hiteshbhoyar03/fpv-flight-controller-v4/gallery/fc 1 mcu.png

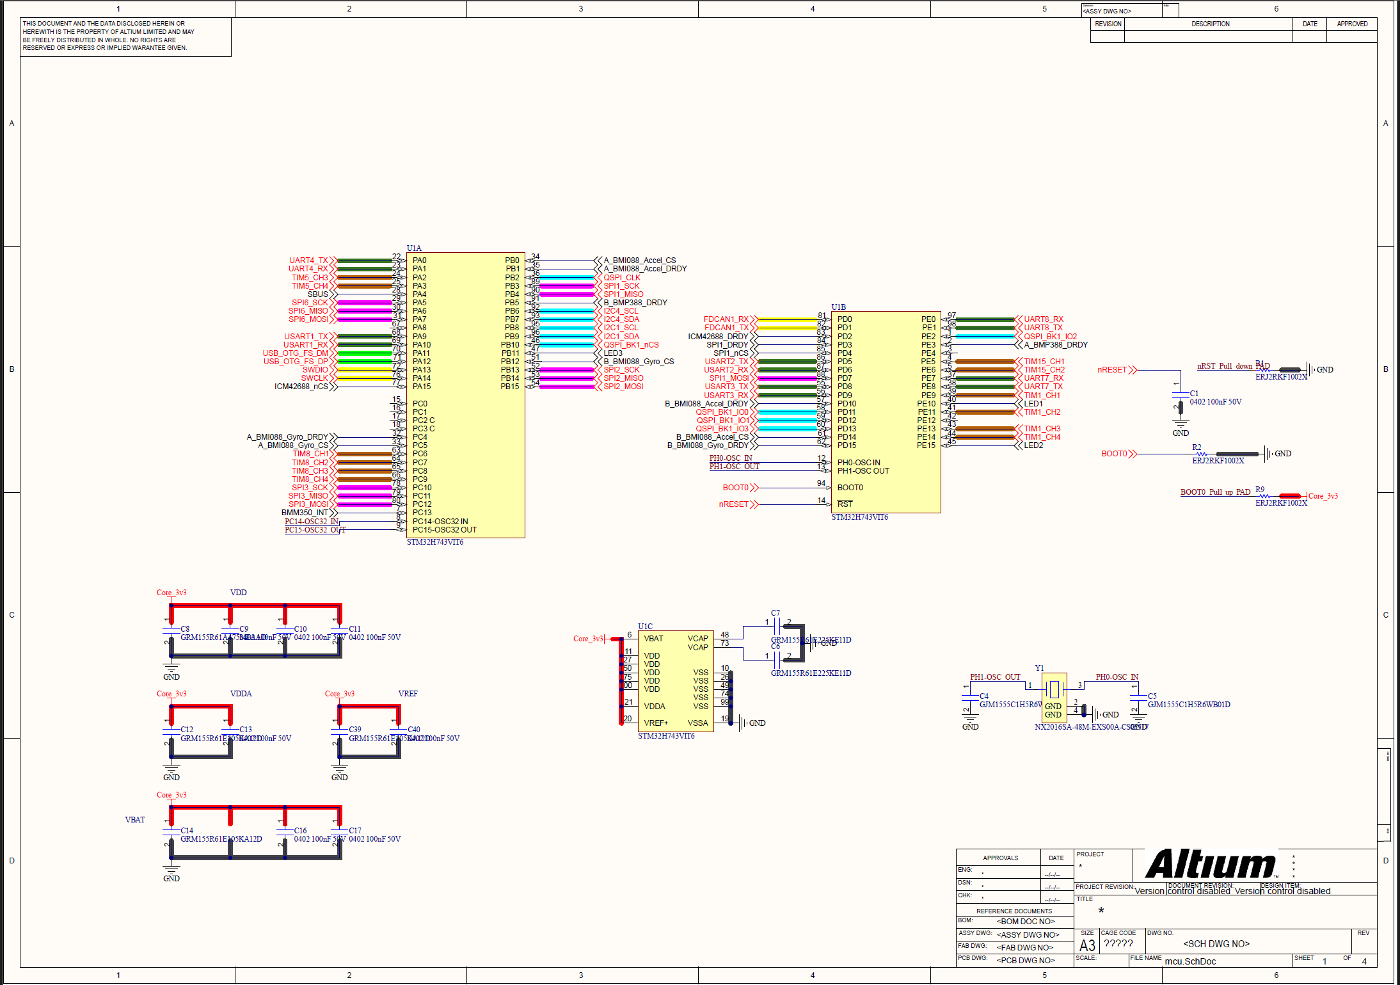
gallery/fc 1 mcu.png
