hiteshbhoyar03/fpv-flight-controller-v4/gallery/fc 2 sensor.png

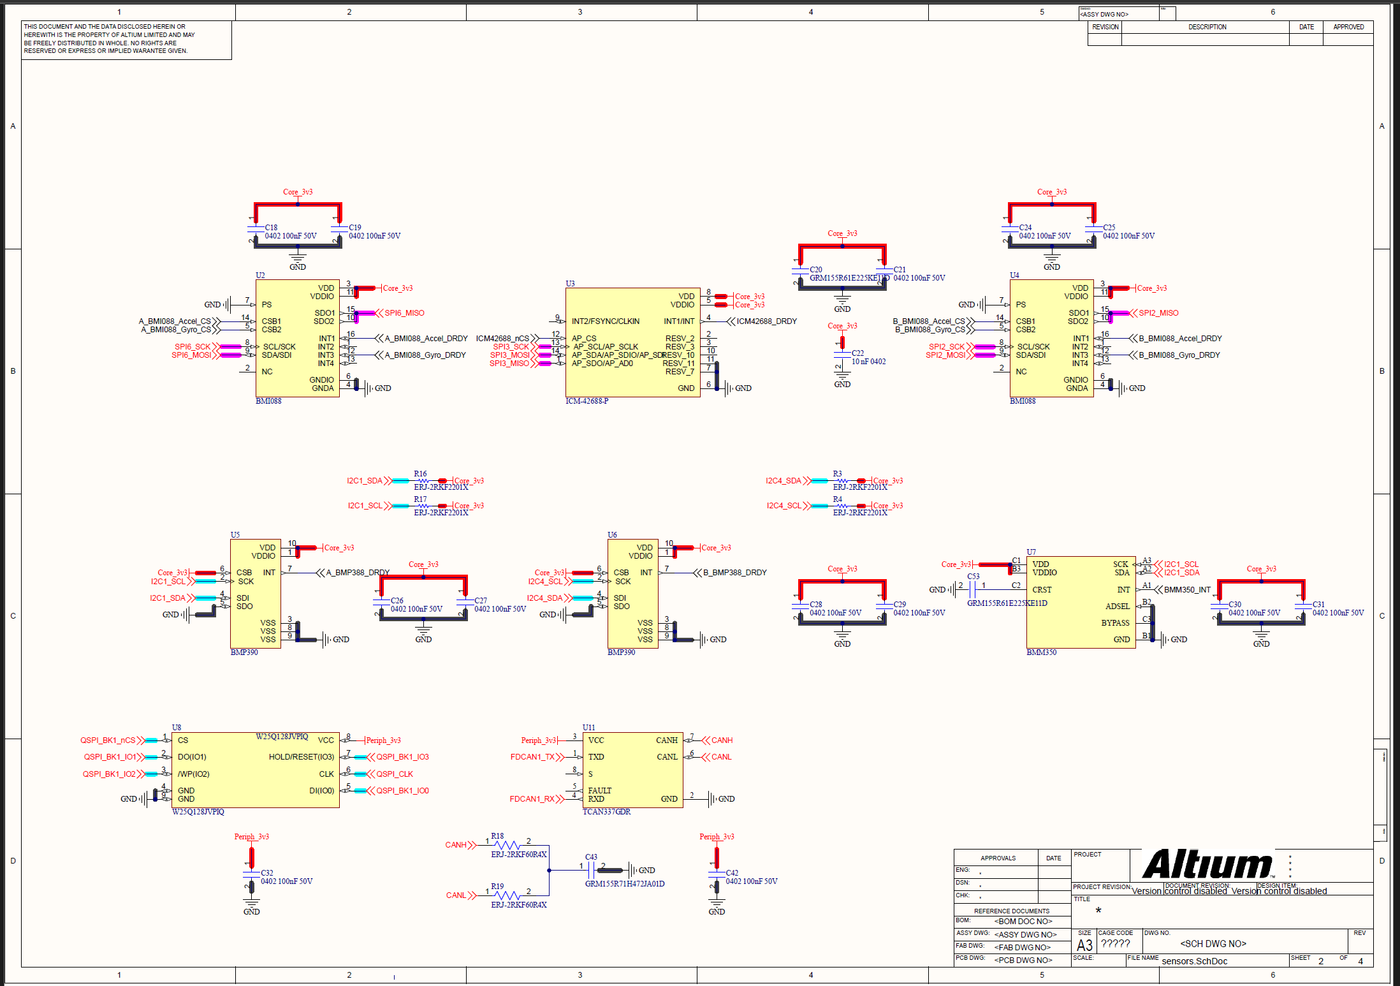
gallery/fc 2 sensor.png
