hiteshbhoyar03/fpv-flight-controller-v4/gallery/fc 3 power.png

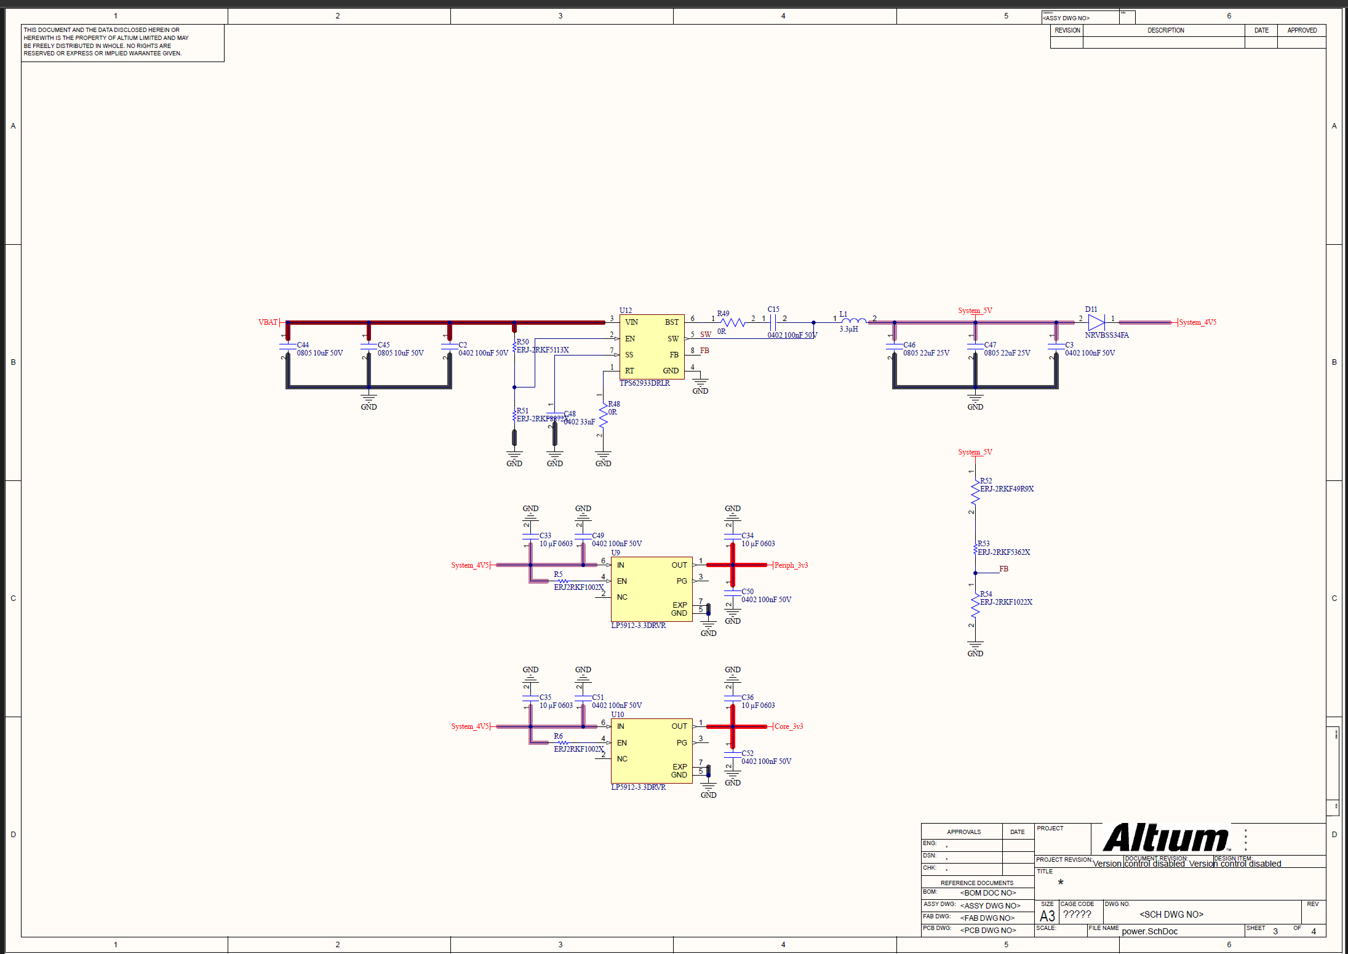
gallery/fc 3 power.png
