hiteshbhoyar03/fpv-flight-controller-v4/gallery/fc 4 ports.png

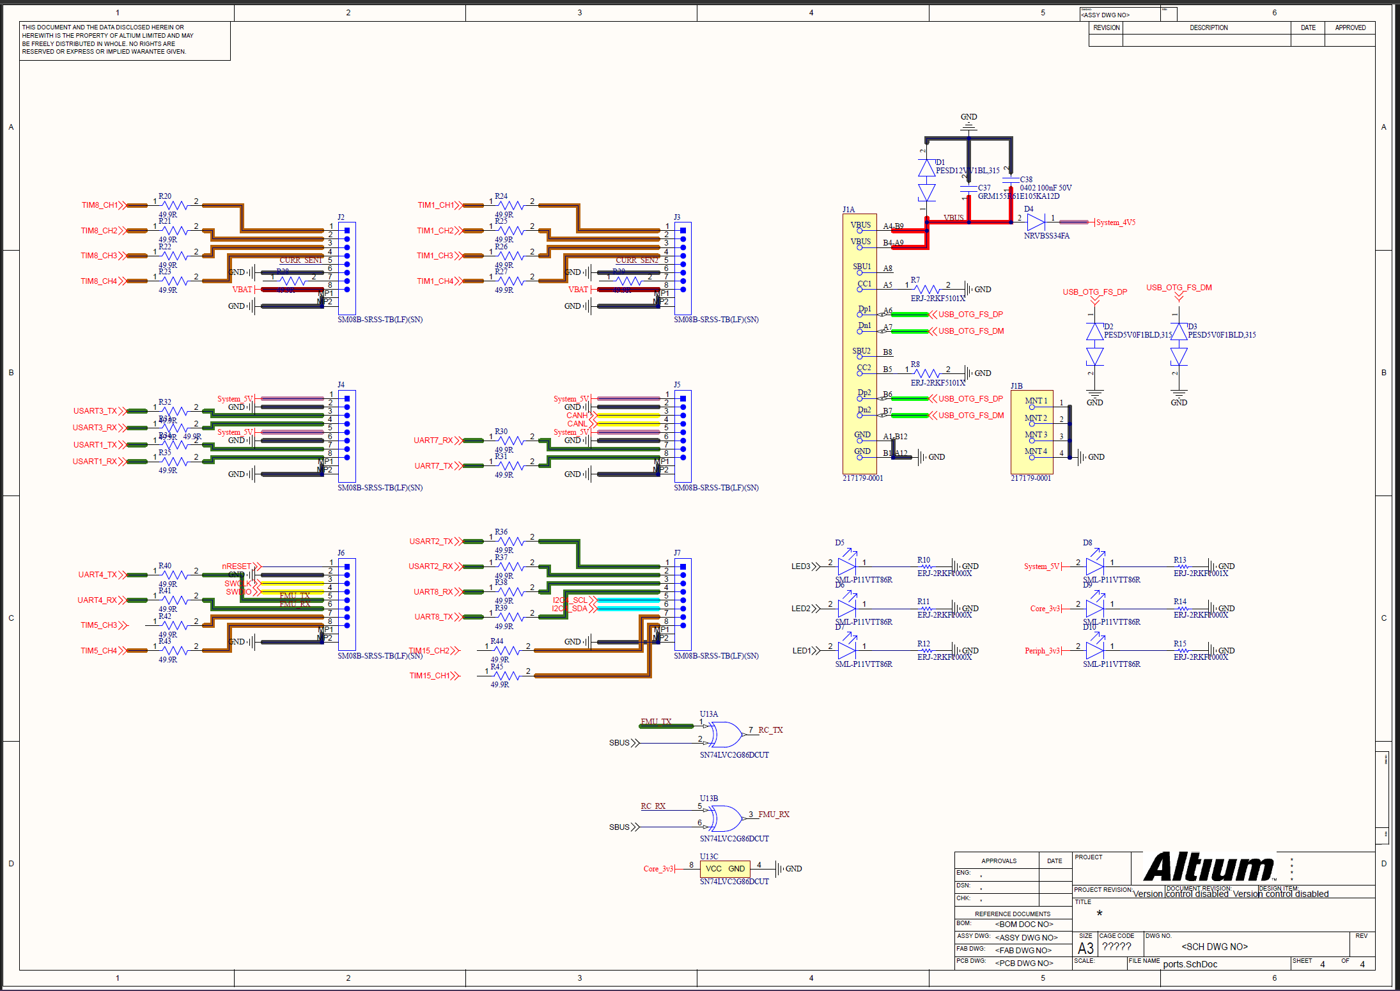
gallery/fc 4 ports.png
