hiteshbhoyar03/fpv-flight-controller-v4/gallery/fc layer1.png

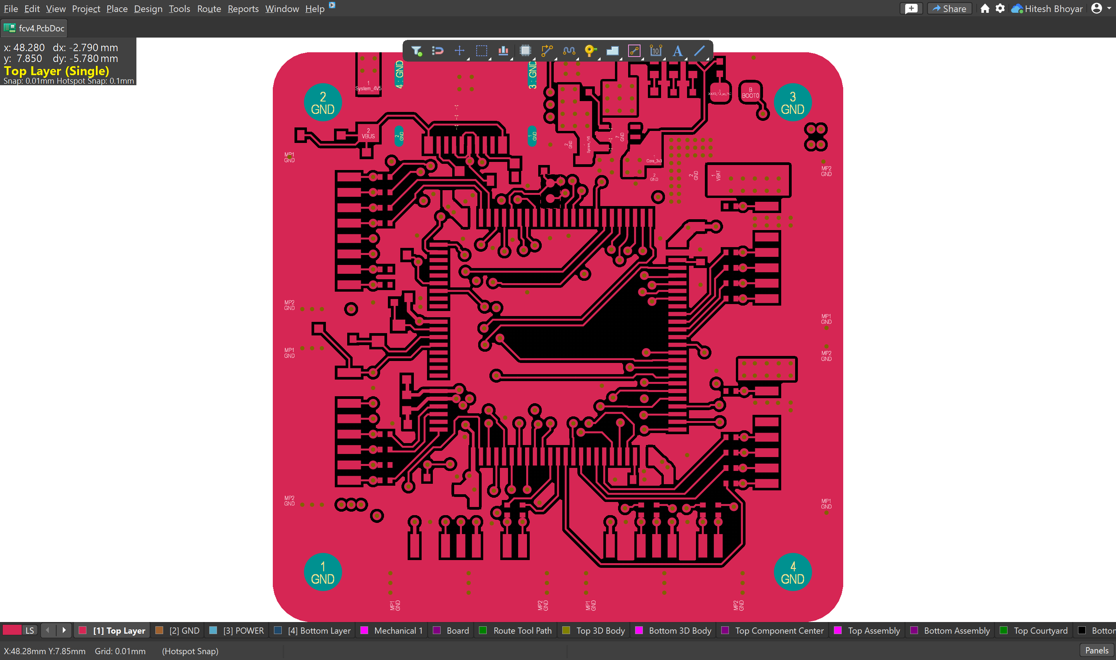
gallery/fc layer1.png
