hiteshbhoyar03/fpv-flight-controller-v4/gallery/fc layer2.png

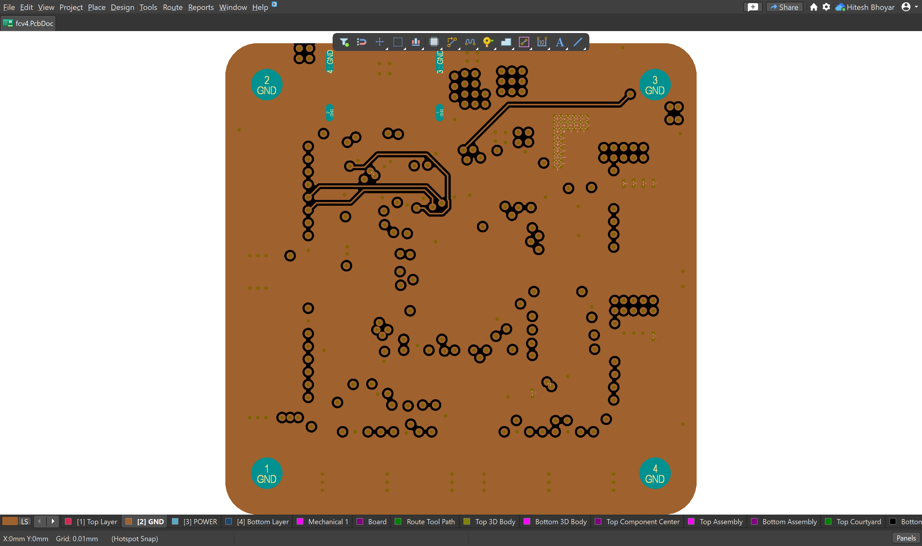
gallery/fc layer2.png
