hiteshbhoyar03/fpv-flight-controller-v4/gallery/fc layer3.png

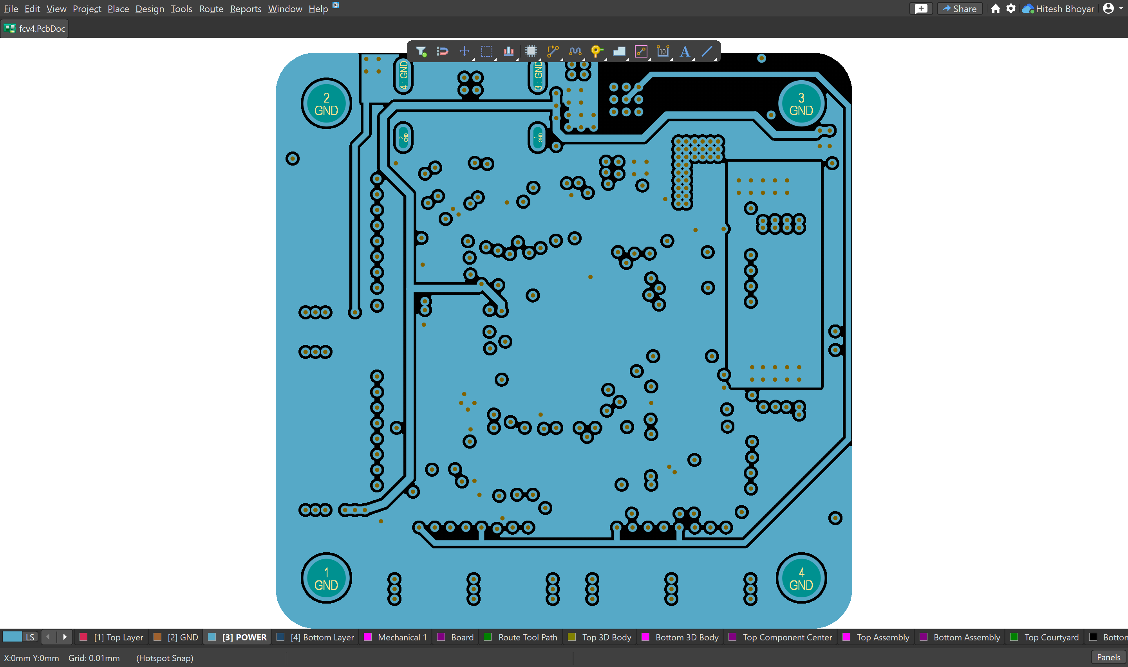
gallery/fc layer3.png
