hiteshbhoyar03/fpv-flight-controller-v4/gallery/fc layer4.png

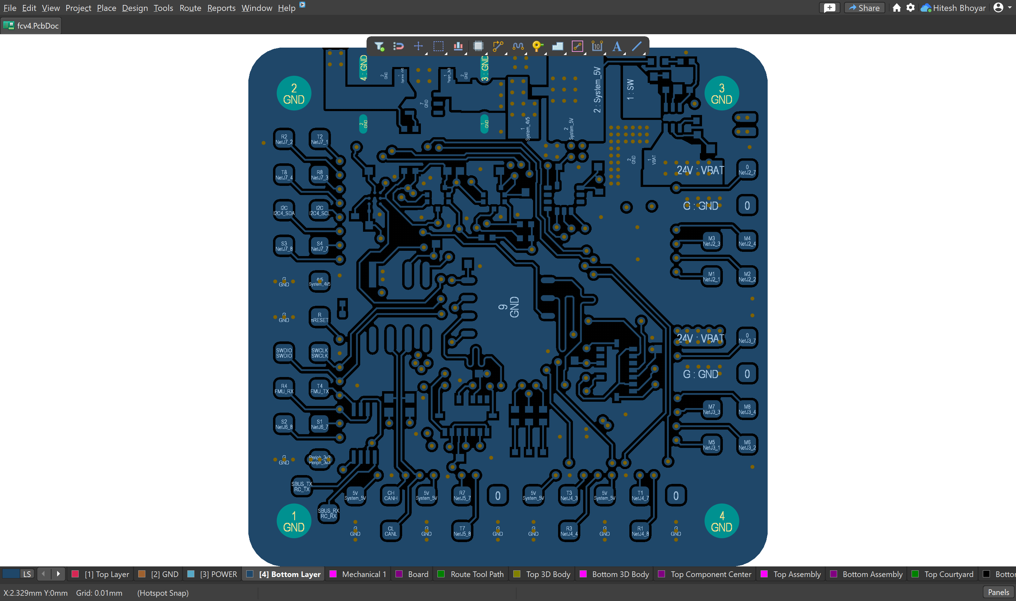
gallery/fc layer4.png
