hiteshbhoyar03/fpv-flight-controller-v4/documentation/fpv fc Assembly Drawings.pdf

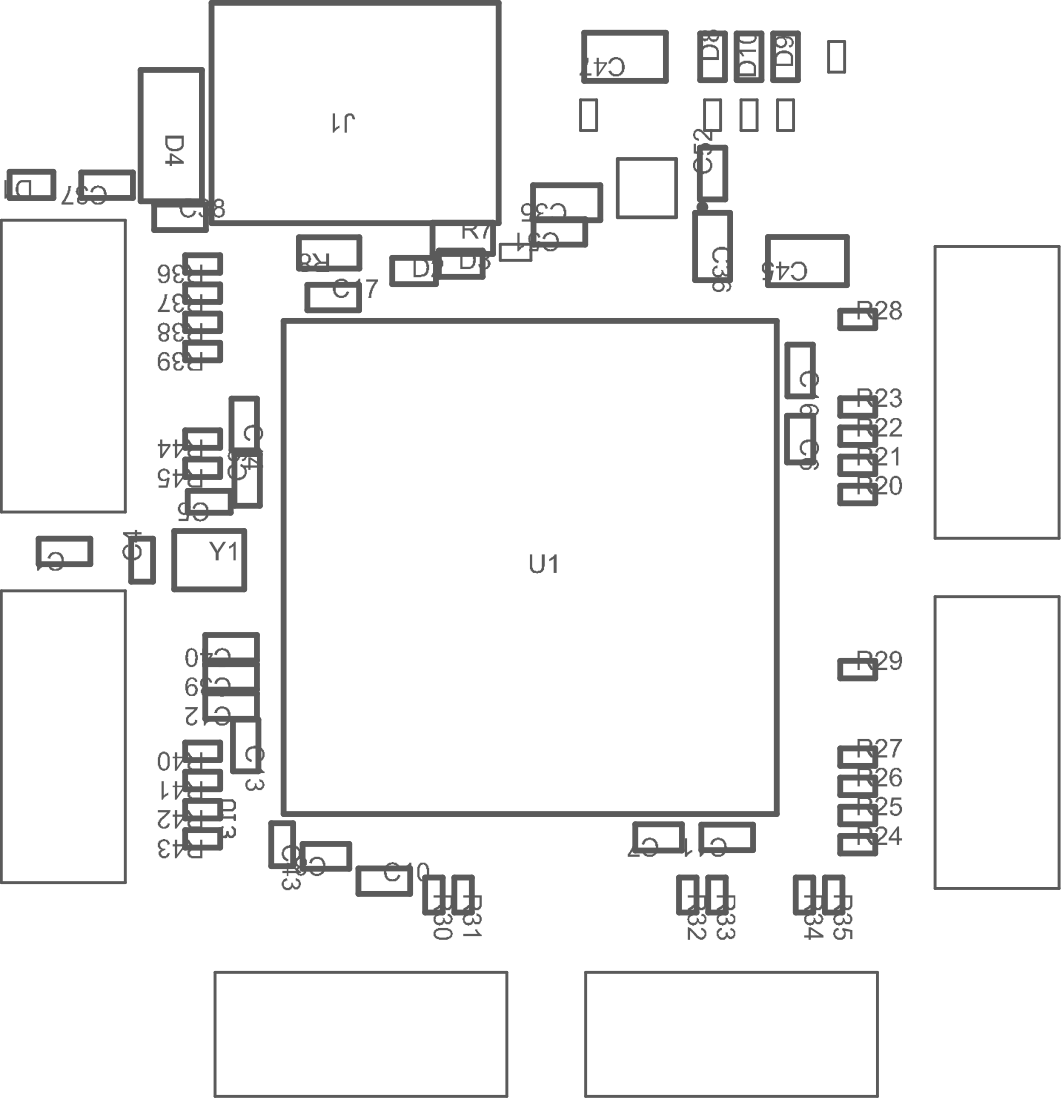
[picture p13: page 1]

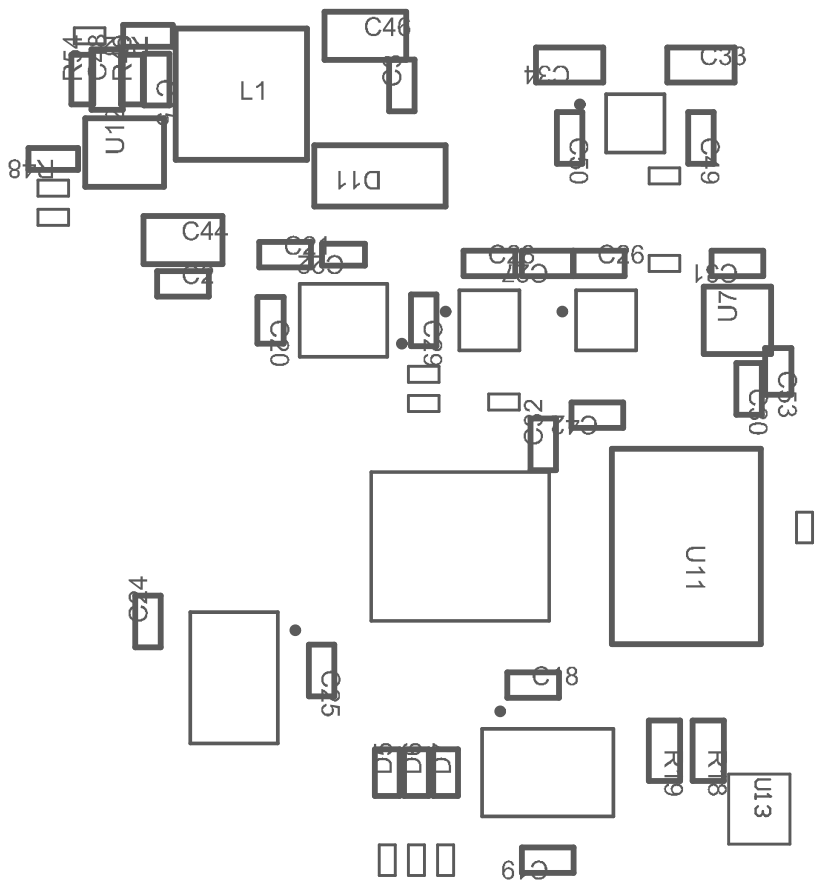
[picture p14: page 2]
