hiteshbhoyar03/fpv-flight-controller-v4/documentation/fpv fc Schematic PDF.pdf

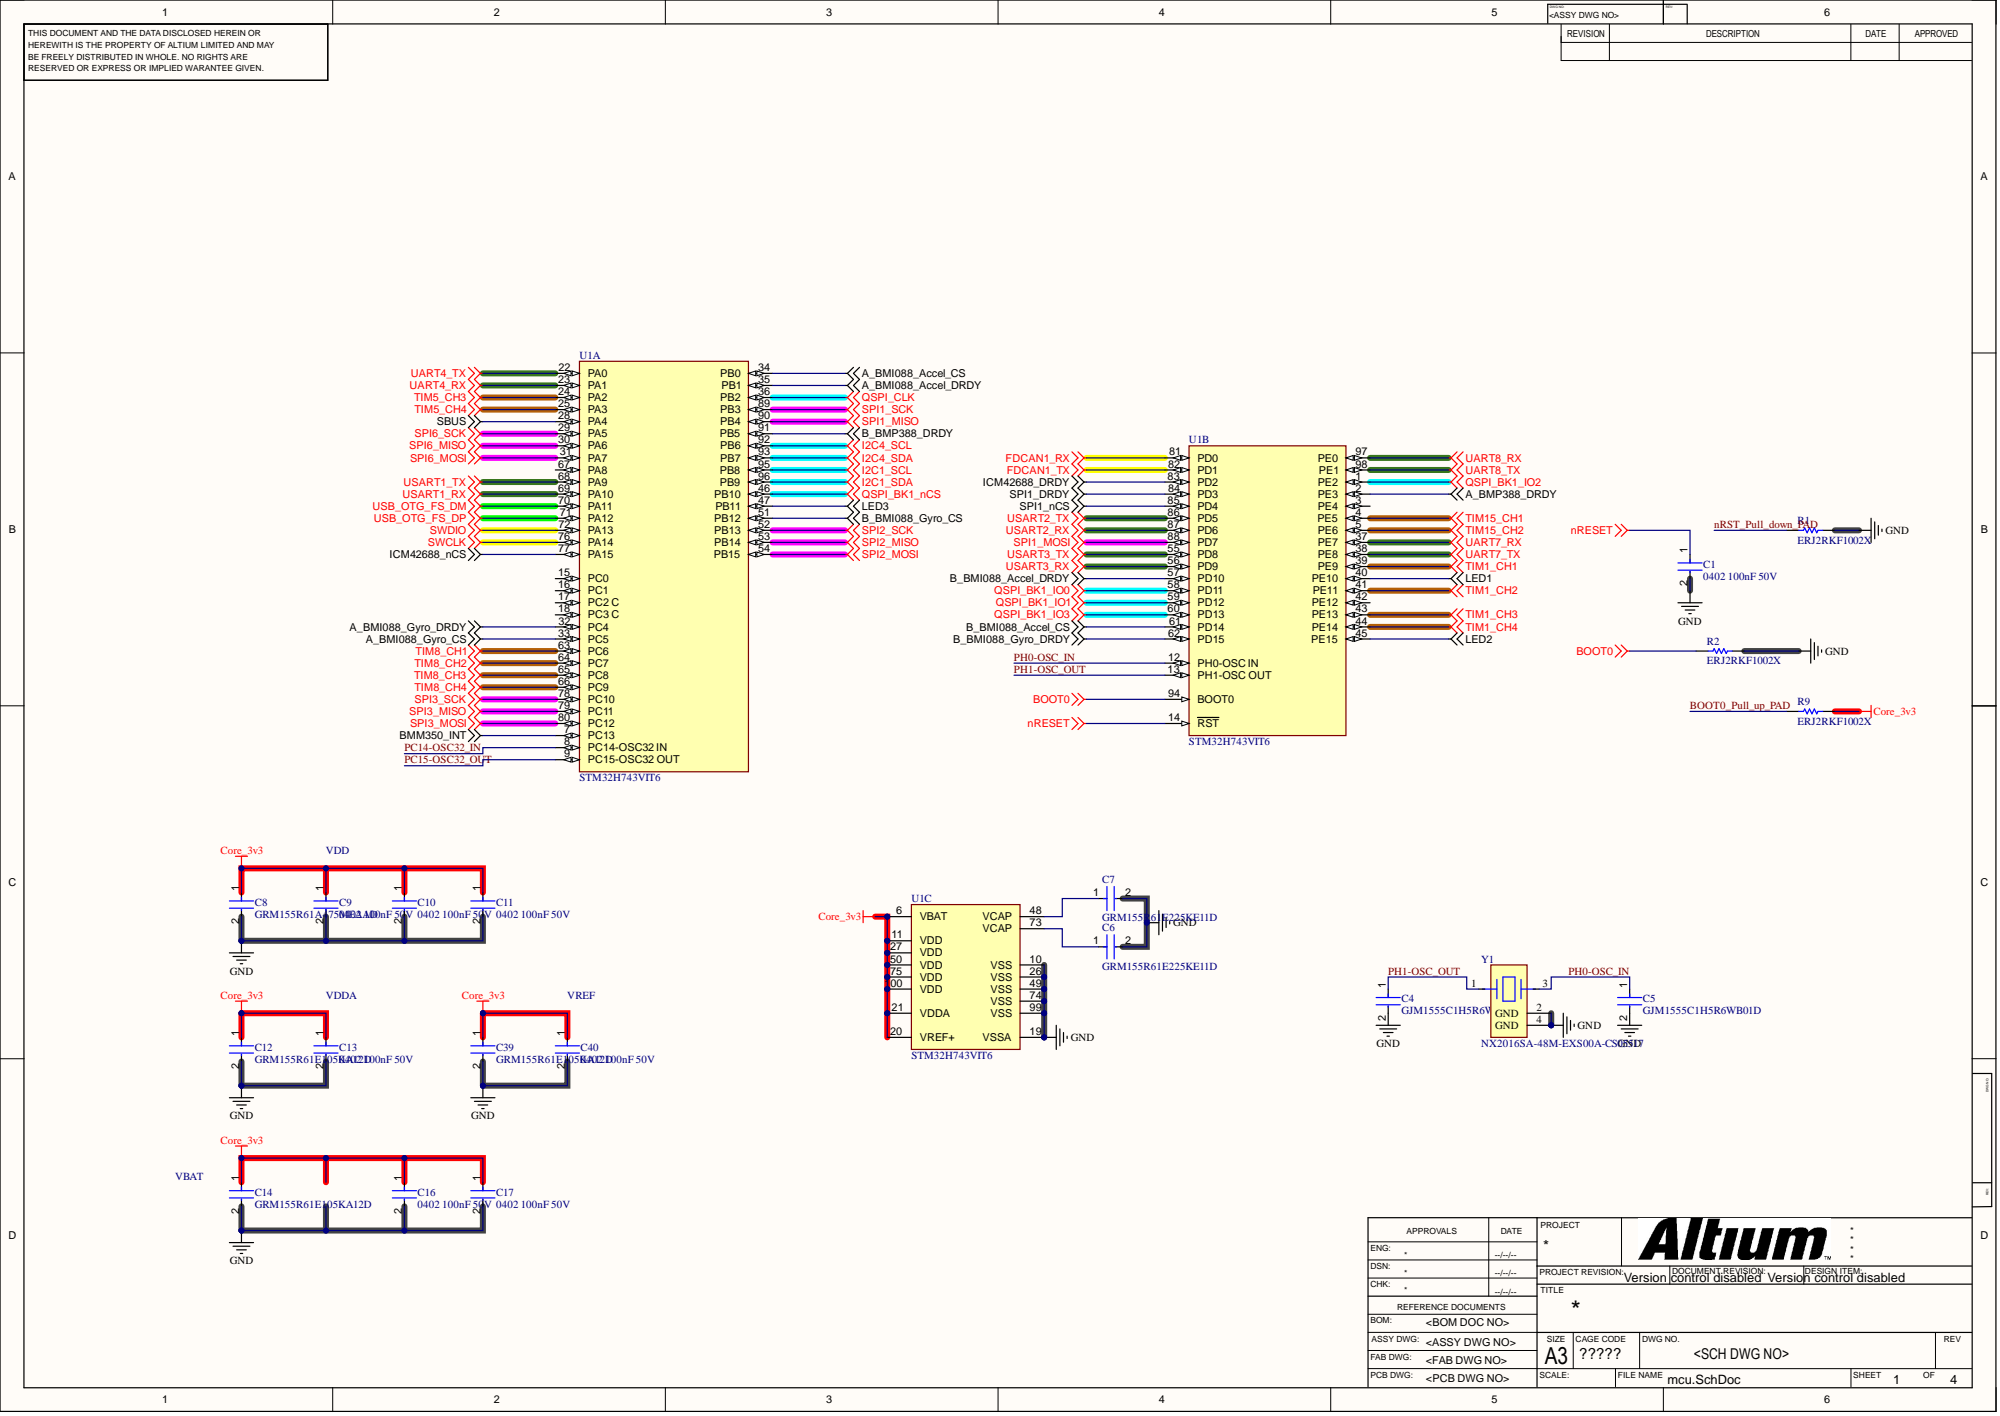
[picture p15: page 1]

DWG NO: <ASSY DWG NO> | REV:

THIS DOCUMENT AND THE DATA DISCLOSED HEREIN OR HEREWITH IS THE PROPERTY OF ALTIUM LIMITED AND MAY BE FREELY DISTRIBUTED IN WHOLE. NO RIGHTS ARE RESERVED OR EXPRESS OR IMPLIED WARANTEE GIVEN. | U1A | REVISION | DESCRIPTION | DATE | APPROVED

DATE | PROJECT * | * * APPROVALS * *

ENG: * | --/--/--

DSN: * | --/--/--

CHK: * | --/--/--

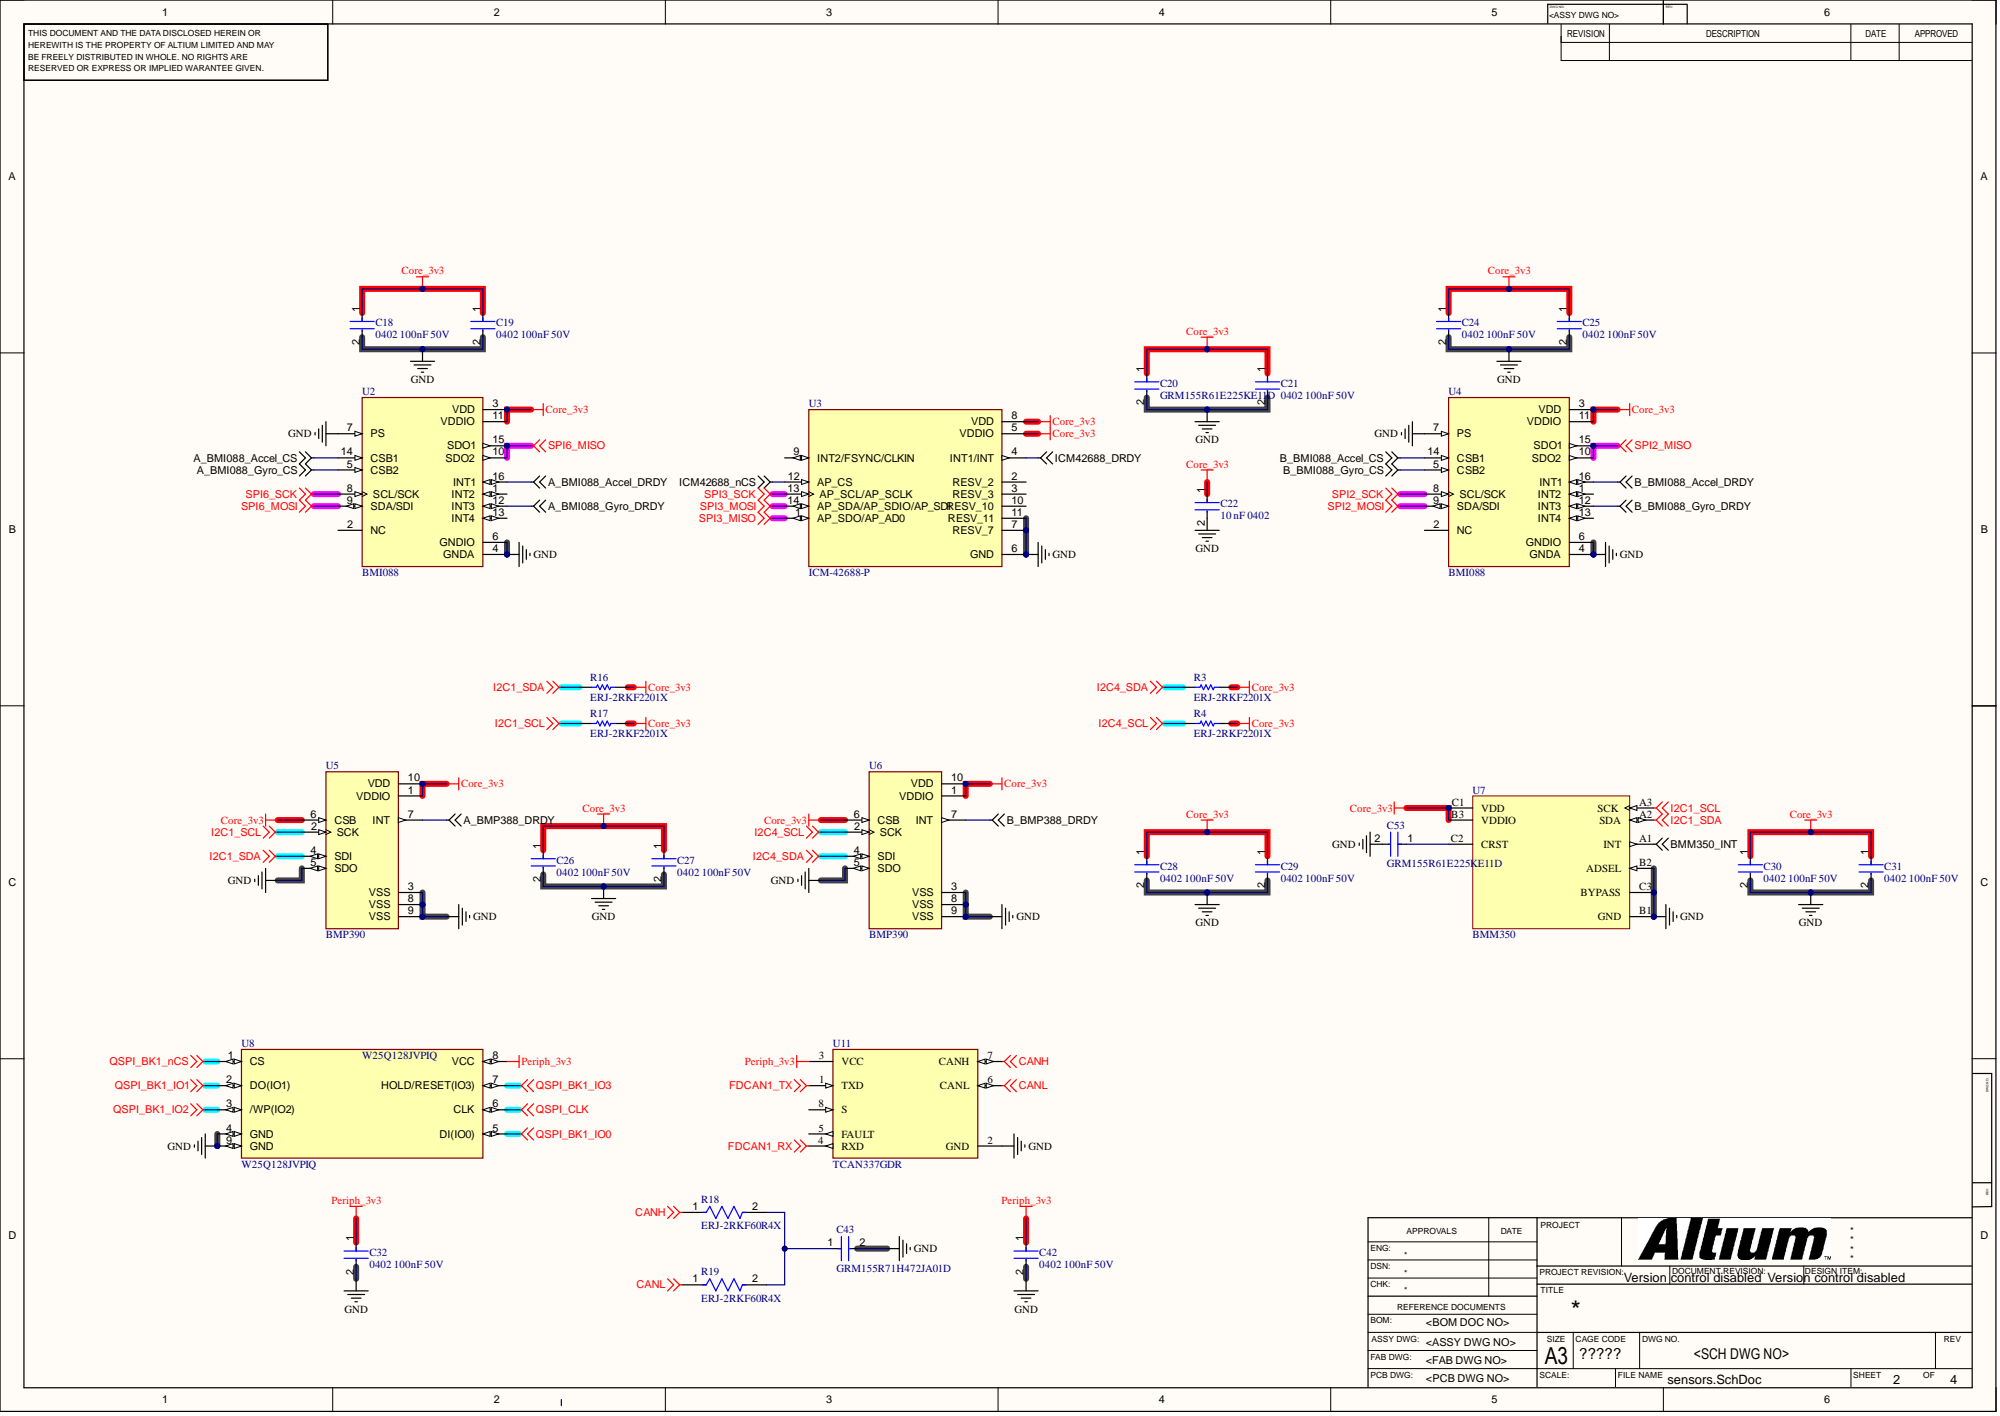
[picture p16: page 2]

DATE | PROJECT | * * APPROVALS * *

ENG: *

DSN: *

CHK: *

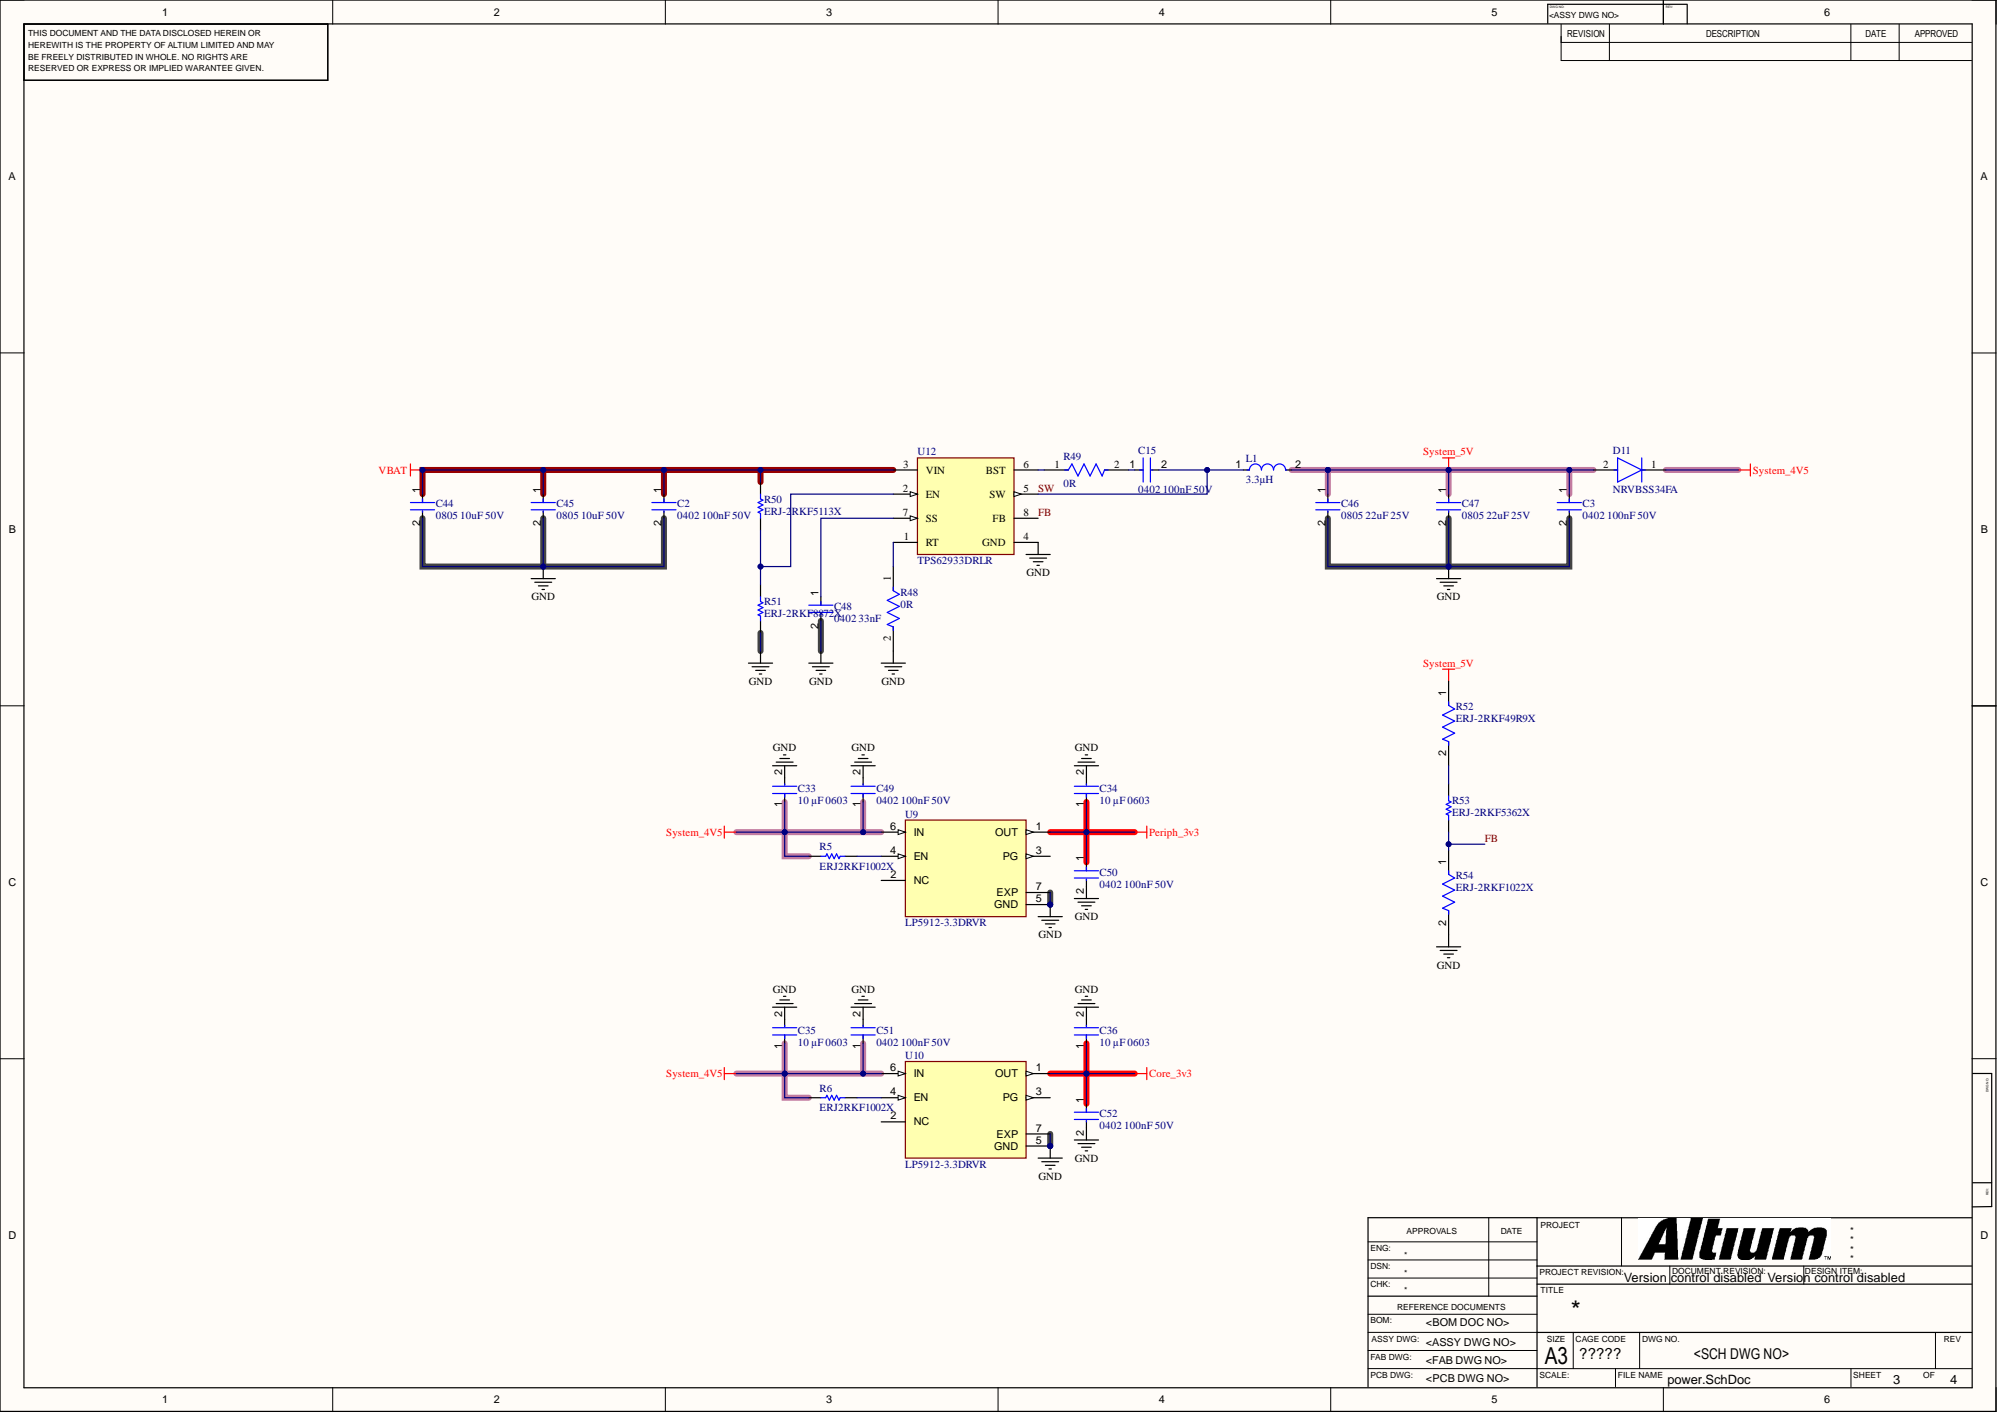
[picture p17: page 3]

D W G N O : <ASSY DWG NO > | R E V :

THIS DOCUMENT AND THE DA TA DISCL OSED HEREIN O R HEREWITH IS THE PROPERTY OF ALTIUM LIMITED AND M AY BE FREELY DISTRIBUTED IN WHO LE. NO RIGHTS ARE | | REVISI O N | DESCRIPTI O N | DATE | APPROVED

R5 0 ERJ-2RKF5 1 1 3 X | 7

DATE | PRO JECT | **** APPROVALS

ENG :
** DSN:

CHK: *

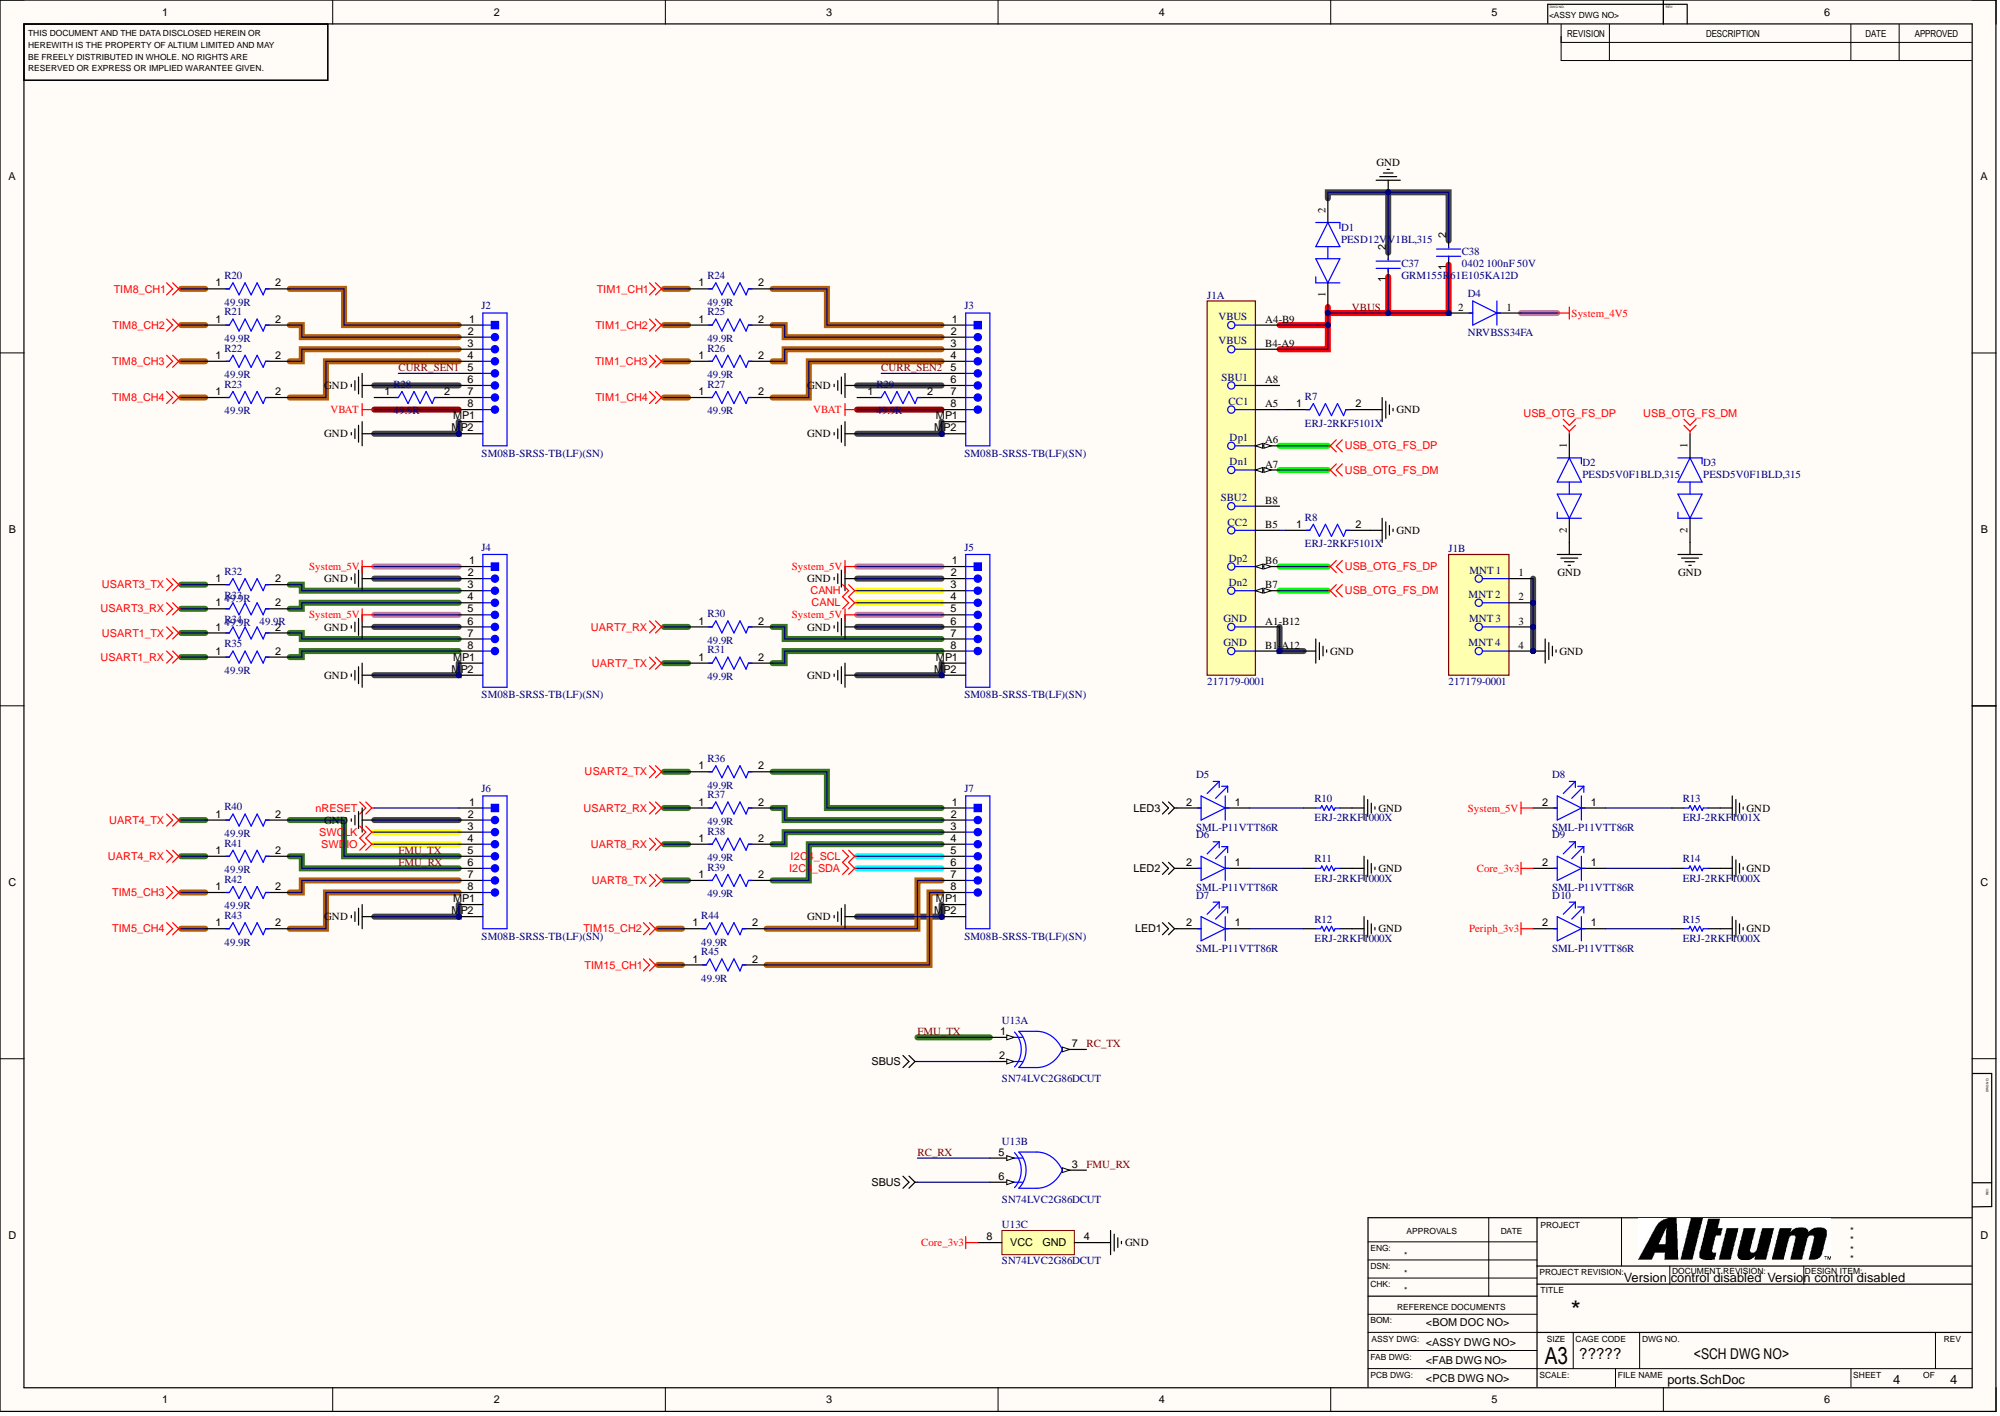
[picture p18: page 4]

SM08B-SRSS-TB(LF)(SN)

DATE | PROJECT | * * APPROVALS * *

ENG: *

DSN: *

CHK: *
