hiteshbhoyar03/fpv-flight-controller-v4/documentation/fc cubemx/fc cubemx.ioc

Mcu.UserName=STM32H743VITx
PA0.Signal=UART4_TX
PA1.Signal=UART4_RX
PA10.Signal=USART1_RX
PA11.Signal=USB_OTG_FS_DM
PA12.Signal=USB_OTG_FS_DP
PA2.Signal=S_TIM5_CH3
PA3.Signal=S_TIM5_CH4
PA4.GPIO_Label=SBUS
PA4.Signal=GPIO_Output
PA5.Signal=SPI6_SCK
PA6.Signal=SPI6_MISO
PA7.Signal=SPI6_MOSI
PA9.Signal=USART1_TX
PB0.GPIO_Label=A_BMI088_Accel_CS
PB0.Signal=GPIO_Output
PB1.GPIO_Label=A_BMI088_Accel_DRDY
PB1.Signal=GPIO_Input
PB10.Signal=QUADSPI_BK1_NCS
PB11.GPIO_Label=LED3
PB11.Signal=GPIO_Output
PB12.GPIO_Label=B_BMI088_Gyro_CS
PB12.Signal=GPIO_Output
PB13.Signal=SPI2_SCK
PB14.Signal=SPI2_MISO
PB15.Signal=SPI2_MOSI
PB2.Signal=QUADSPI_CLK
PB5.GPIO_Label=B_BMP388_DRDY
PB5.Signal=GPIO_Input
PB6.Signal=I2C4_SCL
PB7.Signal=I2C4_SDA
PB8.Signal=I2C1_SCL
PB9.Signal=I2C1_SDA
PC10.Signal=SPI3_SCK
PC11.Signal=SPI3_MISO
PC12.Signal=SPI3_MOSI
PC13.GPIO_Label=BMM350_INT
PC13.Signal=GPIO_Output
PC4.GPIO_Label=A_BMI088_Gyro_DRDY
PC4.Signal=GPIO_Input
PC5.GPIO_Label=A_BMI088_Gyro_CS
PC5.Signal=GPIO_Output
PC6.Signal=S_TIM8_CH1
PC7.Signal=S_TIM8_CH2
PC8.Signal=S_TIM8_CH3
PC9.Signal=S_TIM8_CH4
PD0.Signal=FDCAN1_RX
PD1.Signal=FDCAN1_TX
PD10.GPIO_Label=B_BMI088_Accel_DRDY
PD10.Signal=GPIO_Input
PD11.Signal=QUADSPI_BK1_IO0
PD12.Signal=QUADSPI_BK1_IO1
PD13.Signal=QUADSPI_BK1_IO3
PD14.GPIO_Label=B_BMI088_Accel_CS
PD14.Signal=GPIO_Output
PD15.GPIO_Label=B_BMI088_Gyro_DRDY
PD15.Signal=GPIO_Input
PD2.GPIO_Label=ICM42688_DRDY
PD2.Signal=GPIO_Input
PD3.GPIO_Label=SPI1_DRDY
PD3.Signal=GPIO_Input
PD4.GPIO_Label=SPI1_nCS
PD4.Signal=GPIO_Output
PD5.Signal=USART2_TX
PD6.Signal=USART2_RX
PD7.Signal=SPI1_MOSI
PD8.Signal=USART3_TX
PD9.Signal=USART3_RX
PE0.Signal=UART8_RX
PE1.Signal=UART8_TX
PE10.GPIO_Label=LED1
PE10.Signal=GPIO_Output
PE11.Signal=S_TIM1_CH2
PE13.Signal=S_TIM1_CH3
PE14.Signal=S_TIM1_CH4
PE15.GPIO_Label=LED2
PE15.Signal=GPIO_Output
PE2.Signal=QUADSPI_BK1_IO2
PE3.GPIO_Label=A_BMP388_DRDY
PE3.Signal=GPIO_Input
PE5.Signal=S_TIM15_CH1
PE6.Signal=S_TIM15_CH2
PE7.Signal=UART7_RX
PE8.Signal=UART7_TX
PE9.Signal=S_TIM1_CH1
